gtetil/rpi-shutdown-pcb/rpi-shutdown-pcb.kicad_pcb

## KiCad design rpi-shutdown-pcb.kicad_pcb (2017-09-10)

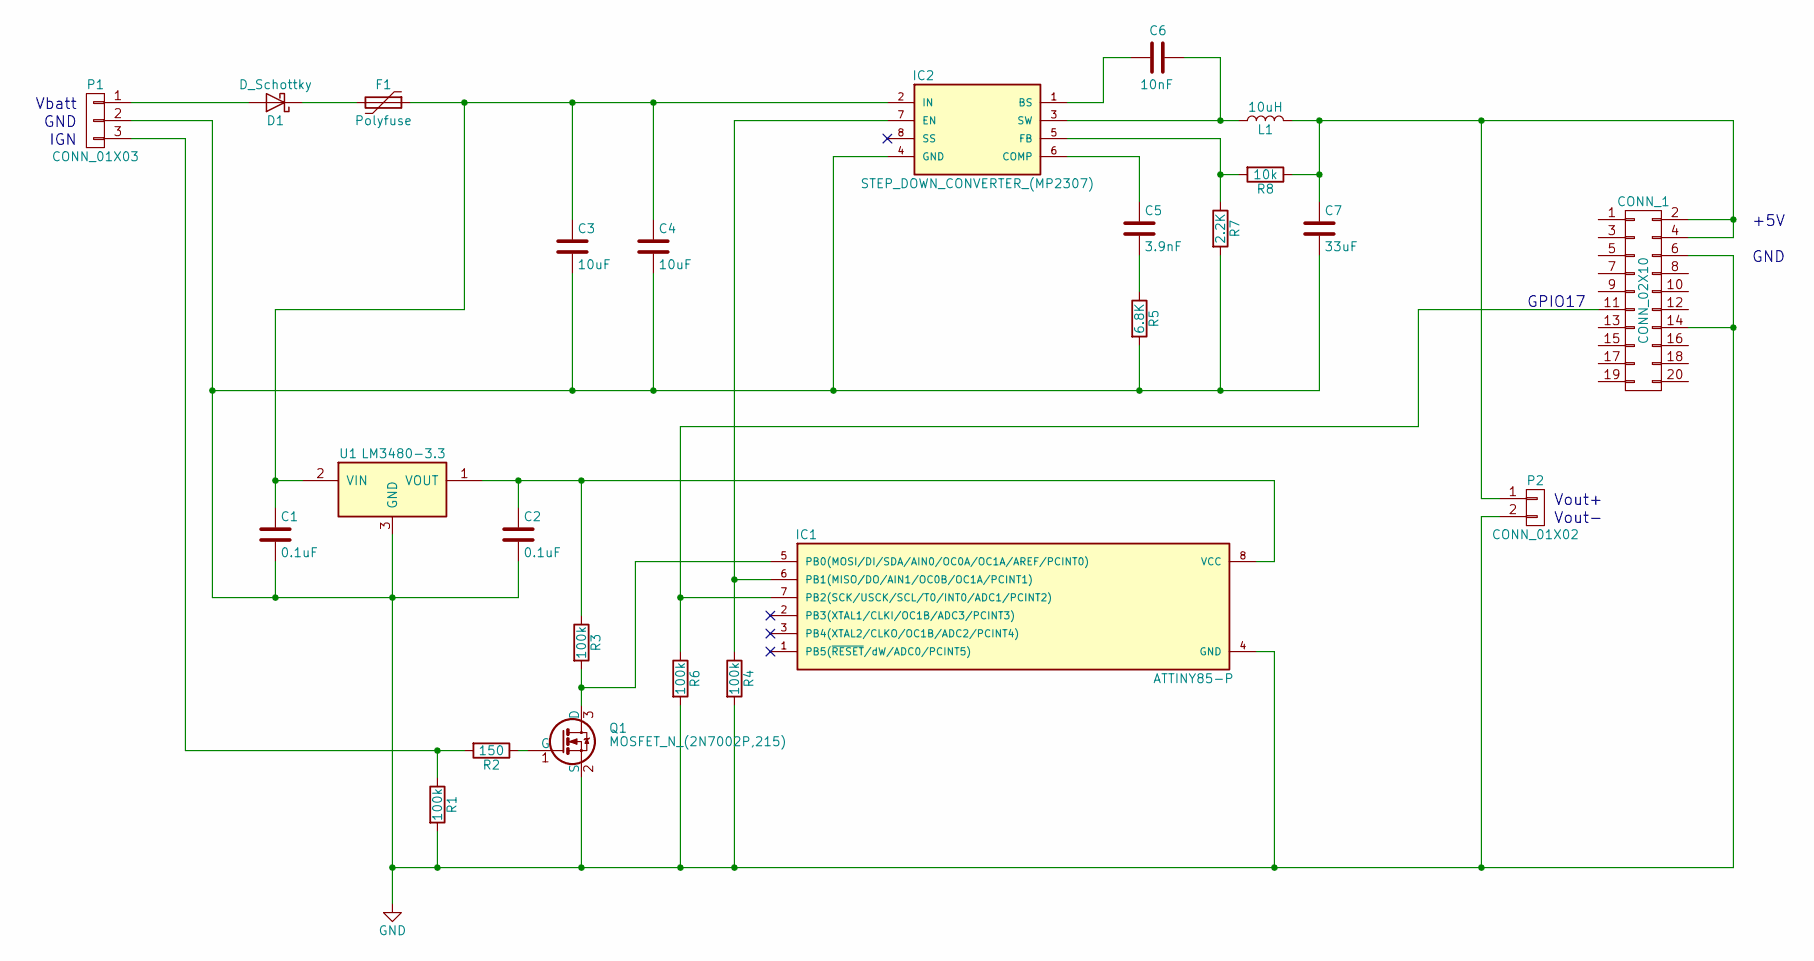
[picture p1: schematic rpi-shutdown-pcb.sch]

Parts:
C1, C2: 0.1uF; R_1206_HandSoldering_(narrow)
C3, C4: 10uF; R_1206_HandSoldering_(narrow)
C5: 3.9nF; C_0805_HandSoldering_(narrow)
C6: 10nF; C_0805_HandSoldering_(narrow)
C7: 33uF; R_1206_HandSoldering_(narrow)
CONN_1: CONN_02X10; HEADER_20_PIN_FEMALE_(PPTC102LFBN-RC)
D1: D_Schottky; DO-214AB
F1: Polyfuse; R_1812_HandSoldering
IC1: ATTINY85-P; DIP-8_W7.62mm
IC2: STEP_DOWN_CONVERTER_(MP2307); SOIC8N_(EXPOSED_PAD)
L1: 10uH; INDUCTOR_10uH_(ASPI-0630LR)
P1: CONN_01X03; 3_PADS_FOR_18_AWG_WIRE
P2: CONN_01X02; 2_PADS_FOR_18_AWG_WIRE
Q1: MOSFET_N_(2N7002P,215); SOT-23_Handsoldering
R1, R3, R4, R6: 100k; R_1206_HandSoldering_(narrow)
R2: 150; R_1206_HandSoldering_(narrow)
R5: 6.8K; R_1206_HandSoldering_(narrow)
R7: 2.2K; R_1206_HandSoldering_(narrow)
R8: 10k; R_1206_HandSoldering_(narrow)
U1: LM3480-3.3; SOT-23_Handsoldering

Connections:
GND: C1.2, C2.2, C3.2, C4.2, C7.2, CONN_1.6, CONN_1.14, IC1.4 (GND), IC2.4 (GND), IC2.9 (GND), P1.2, P2.2, Q1.2 (S), R1.2, R4.2, R5.2, R6.2, R7.2, U1.3 (GND)
unnamed: C1.1, C3.1, C4.1, F1.1, IC2.2 (IN), U1.2 (VIN)
unnamed: C2.1, IC1.8 (VCC), R3.1, U1.1 (VOUT)
unnamed: C5.1, IC2.6 (COMP)
unnamed: C5.2, R5.1
unnamed: C6.1, IC2.3 (SW), L1.1
unnamed: C6.2, IC2.1 (BS)
unnamed: C7.1, CONN_1.2, CONN_1.4, L1.2, P2.1, R8.1
unnamed: CONN_1.11, IC1.7 (PB2(SCK/USCK/SCL/T0/INT0/ADC1/PCINT2)), R6.1
unnamed: D1.1 (K), F1.2
unnamed: D1.2 (A), P1.1
unnamed: IC1.5 (PB0(MOSI/DI/SDA/AIN0/OC0A/OC1A/AREF/PCI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), Q1.3 (D), R3.2
unnamed: IC1.6 (PB1(MISO/DO/AIN1/OC0B/OC1A/PCINT1)), IC2.7 (EN), R4.1
unnamed: IC2.5 (FB), R7.1, R8.2
unnamed: P1.3, R1.1, R2.2
unnamed: Q1.1 (G), R2.1

Notes on the sheet:
Vbatt
GND
IGN
Vout+
Vout-
GPIO17
+5V

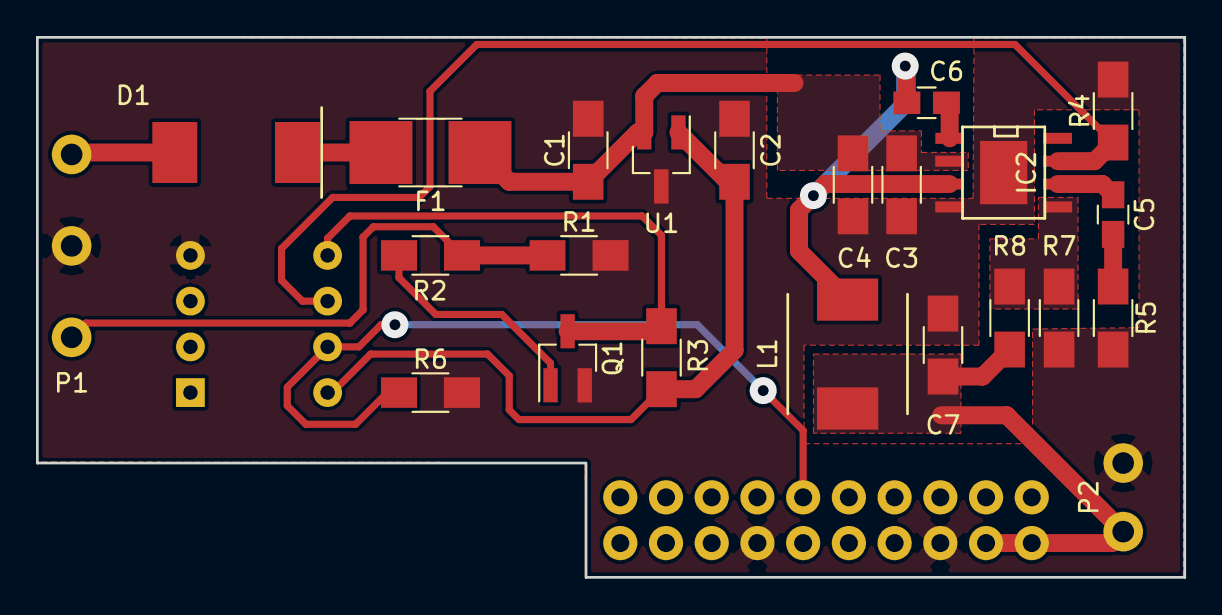
[picture p2: board rpi-shutdown-pcb.kicad_pcb from above]

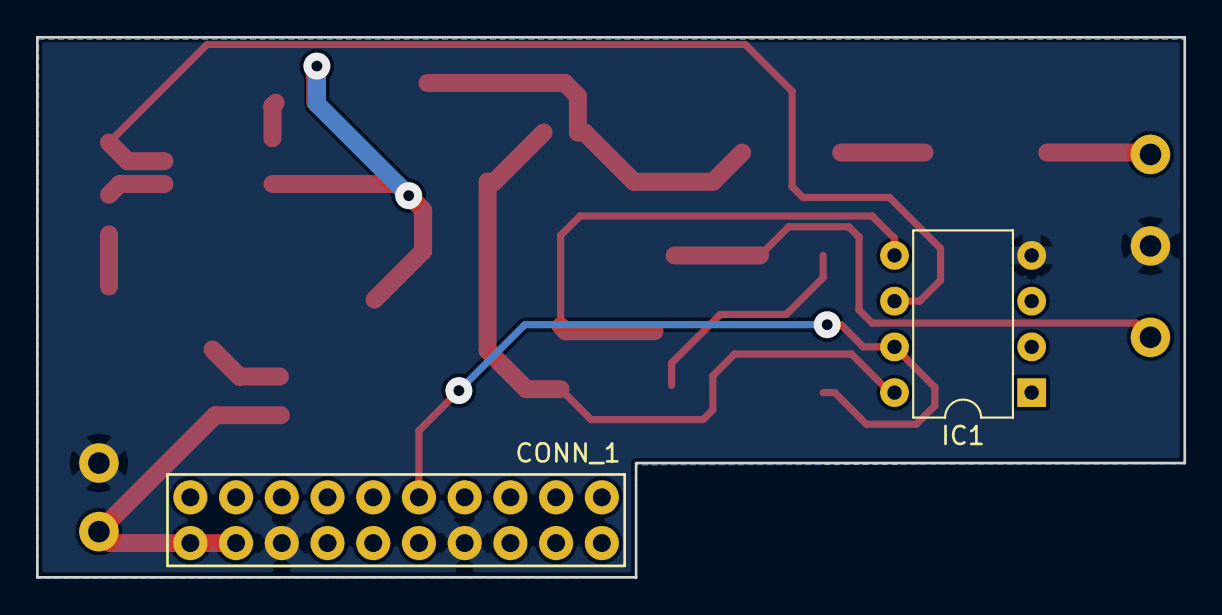
[picture p3: board rpi-shutdown-pcb.kicad_pcb from below]

Board: 2 copper layers, 63.7 x 30.0 mm, 25 parts (2 on the bottom side), 16 nets.
