gtetil/rpi-shutdown-pcb/(threads)

Thread 1 (2017-08-29):

Issues with v1.0

gtetil, 2017-08-29:
-After build, replaced R7 with a 2.0kohm resistor to increase the voltage to account for voltage drop.  Kept getting lightning bolt on RPi.  Need to get a better understanding of why it won't regulate to exactly 5V with increased current.
