gtetil/rpi-shutdown-pcb/(commit log)

2017-03-28 finished revised circuit with P-channel FET and footprints
    [rpi-shutdown-pcb.kicad_pcb, rpi-shutdown-pcb.sch]
2017-03-30 -finished pcb layout.
    [rpi-shutdown-pcb.kicad_pcb, rpi-shutdown-pcb.sch]
2017-03-31 created gerbers and lmd file.
    [rpi-shutdown-pcb-B.Cu.gbr, rpi-shutdown-pcb-Edge.Cuts.gbr, rpi-shutdown-pcb-F.Cu.gbr, rpi-shutdown-pcb.drl]
2017-06-14 Finished adding step-down converter circuit. Need to start on footprints.
    [rpi-shutdown-pcb.sch]
2017-06-18 Finished footprints.
    [rpi-shutdown-pcb.sch]
2017-06-25 Finished PCB layout. Ready to try routing.
    [rpi-shutdown-pcb.kicad_pcb, rpi-shutdown-pcb.sch]
2017-09-10 - Rearranged board to hopefully get better voltage regulation.
    [rpi-shutdown-pcb.kicad_pcb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]
